WiseKensai/pecanpico4/(commit log)

2013-11-12 Added breakout for I2C, ADC2/3
    [PecanPico4.brd, PecanPico4.sch]
2013-11-12 W2CXM Customizations
    Converted to W2CXM callsign, "Ursine Pico 1" name, and Mike Wozowski
    logo.
    [PecanPico4.brd]
2013-11-13 Added Docs and Notes folder, email addy.
    Starting to document the Gerber Layers. Added email address to
    Soldermask.
2013-11-14 Updated the gerber layers doc.
2013-11-14 Guess at gerber layers
2013-11-14 Added Gerber export Job File
2013-11-14 First Gerber Build
    [PecanPico4.GBL, PecanPico4.GBO, PecanPico4.GBP, PecanPico4.GBS, PecanPico4.GTL, PecanPico4.GTO, PecanPico4.GTP, PecanPico4.GTS]
2013-11-14 New gerbers, updated job file
    [PecanPico4.GBL, PecanPico4.GBO, PecanPico4.GBP, PecanPico4.GBS, PecanPico4.GTL, PecanPico4.GTO, PecanPico4.GTP, PecanPico4.GTS]
2013-11-14 Updated zip file
    [DRILEGEND.CFG]
2013-11-14 Added a "Board Outline" file
    So that "oshpark.com" likes the board.
    [PecanPico4.GKO]
2013-11-15 Corrected name _ Ursus MINIMUS.
    Doh
    [PecanPico4.GBL, PecanPico4.GBO, PecanPico4.GBP, PecanPico4.GBS, PecanPico4.GTL, PecanPico4.GTO, PecanPico4.GTP, PecanPico4.GTS]
2013-12-21 i2c changes
